challengerssesicrz-sketch/Challengers-Soccer-2026/Fotos/WhatsApp Image 2026-05-27 at 15.08.53.jpeg

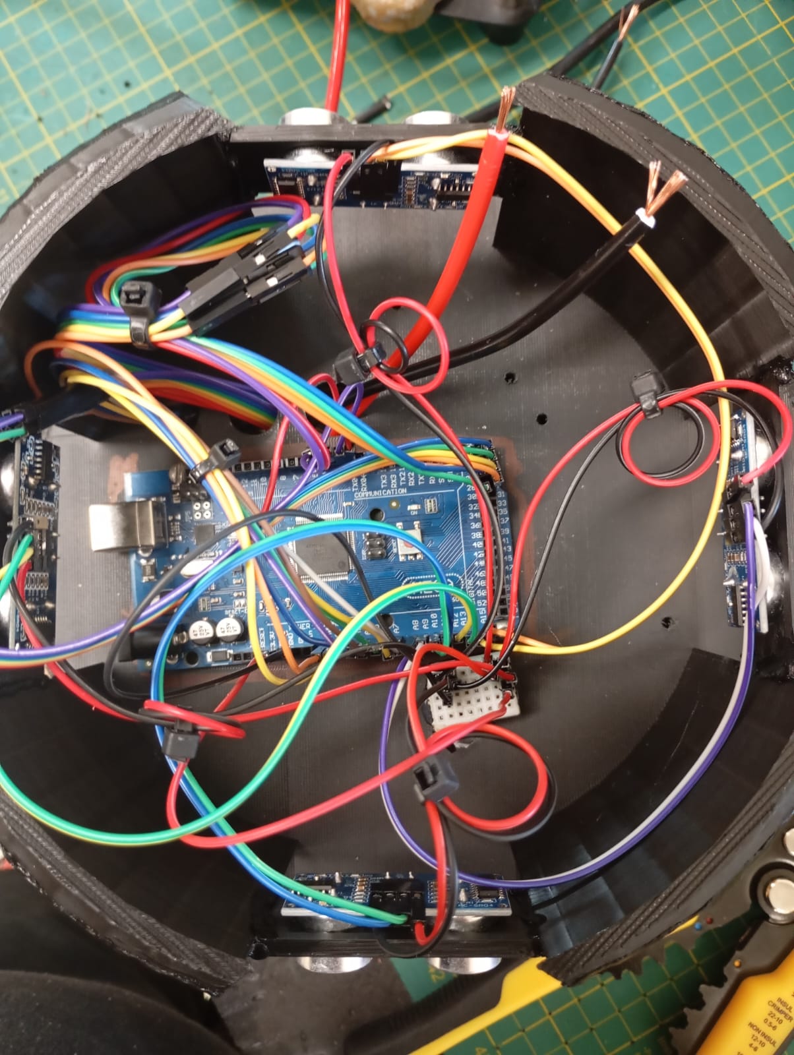
Fotos/WhatsApp Image 2026-05-27 at 15.08.53.jpeg
