challengerssesicrz-sketch/Challengers-Soccer-2026/Fotos/WhatsApp Image 2026-05-18 at 13.47.44 (4).jpeg

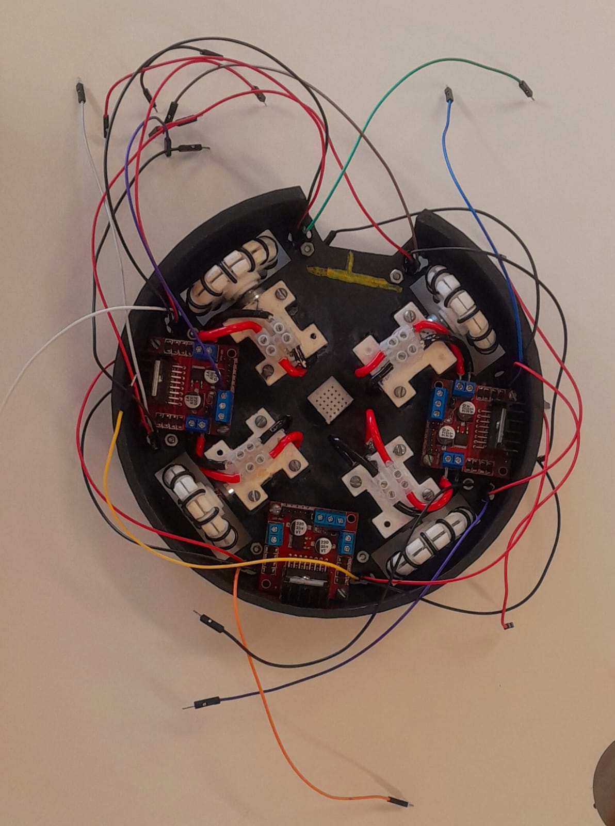
Fotos/WhatsApp Image 2026-05-18 at 13.47.44 (4).jpeg
