challengerssesicrz-sketch/Challengers-Soccer-2026/README.md

# Challengers-Soccer-2026
⚽ Repositório oficial da equipe Challengers (SESI 401 - Cruzeiro/SP). Firmware e documentação dos robôs autônomos de futebol desenvolvidos para a categoria RoboCupJunior Soccer Lightweight 2026. Baseado em Arduino Mega 2560 e design modular de alta performance.
