challengerssesicrz-sketch/Challengers-Soccer-2026/CAD_3D/camada_1_novo-removebg-preview.png

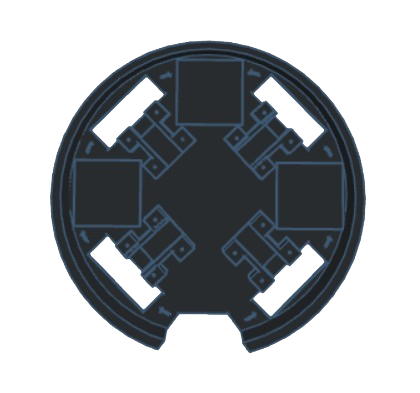
CAD_3D/camada_1_novo-removebg-preview.png
