challengerssesicrz-sketch/Challengers-Soccer-2026/Fotos/WhatsApp Image 2026-05-18 at 16.20.59 (1).jpeg

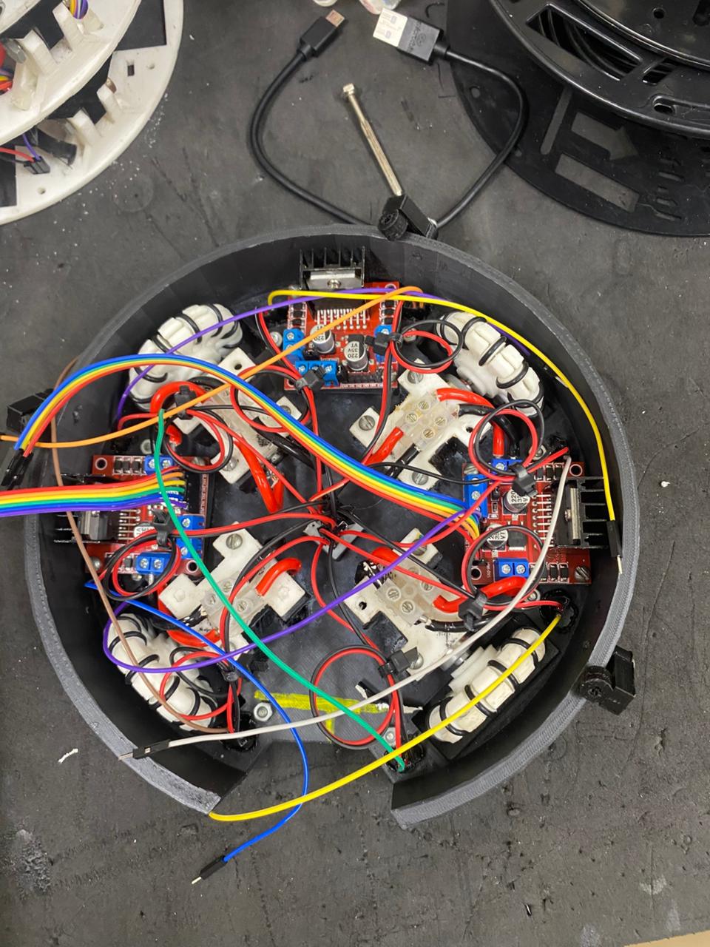
Fotos/WhatsApp Image 2026-05-18 at 16.20.59 (1).jpeg
