challengerssesicrz-sketch/Challengers-Soccer-2026/Fotos/WhatsApp Image 2026-05-27 at 16.37.21 (1).jpeg

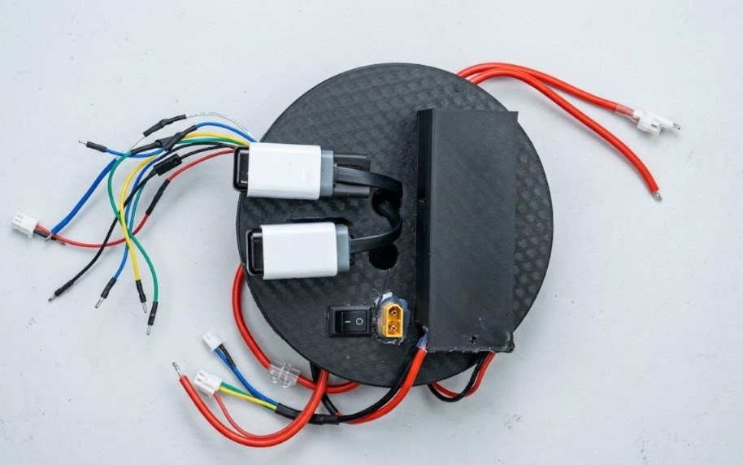
Fotos/WhatsApp Image 2026-05-27 at 16.37.21 (1).jpeg
