challengerssesicrz-sketch/Challengers-Soccer-2026/Fotos/WhatsApp Image 2026-06-11 at 21.22.09 (1).jpeg

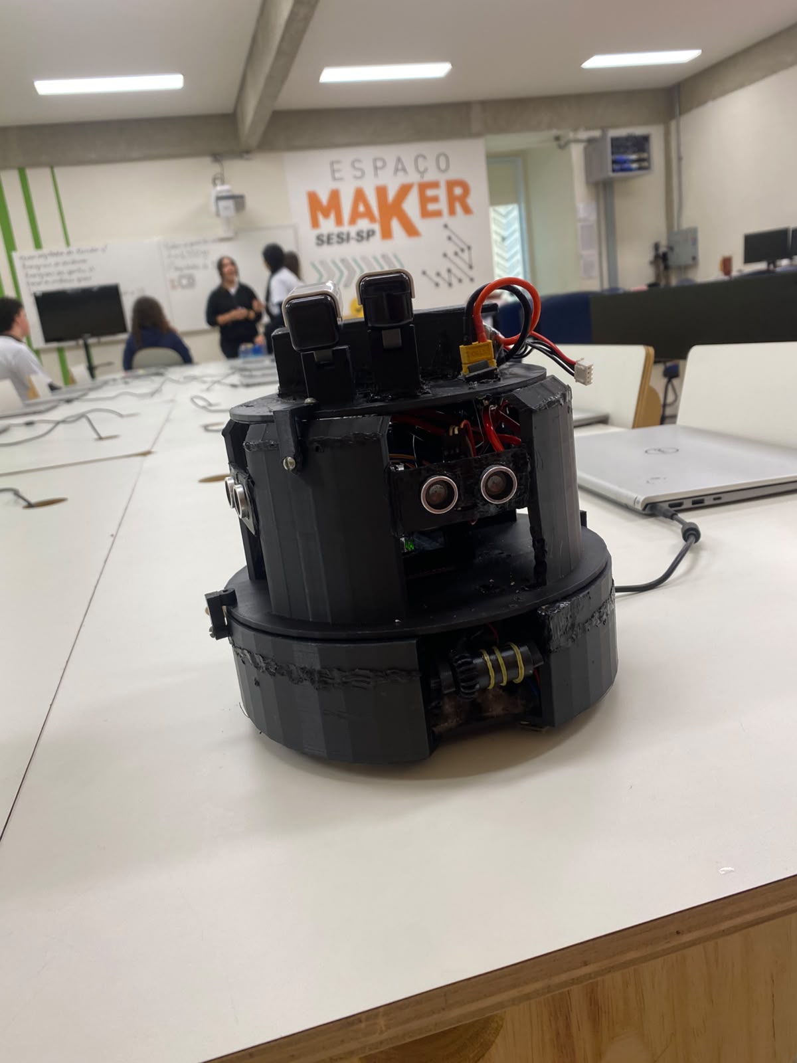
Fotos/WhatsApp Image 2026-06-11 at 21.22.09 (1).jpeg
