challengerssesicrz-sketch/Challengers-Soccer-2026/CAD_3D/Bussola.stl

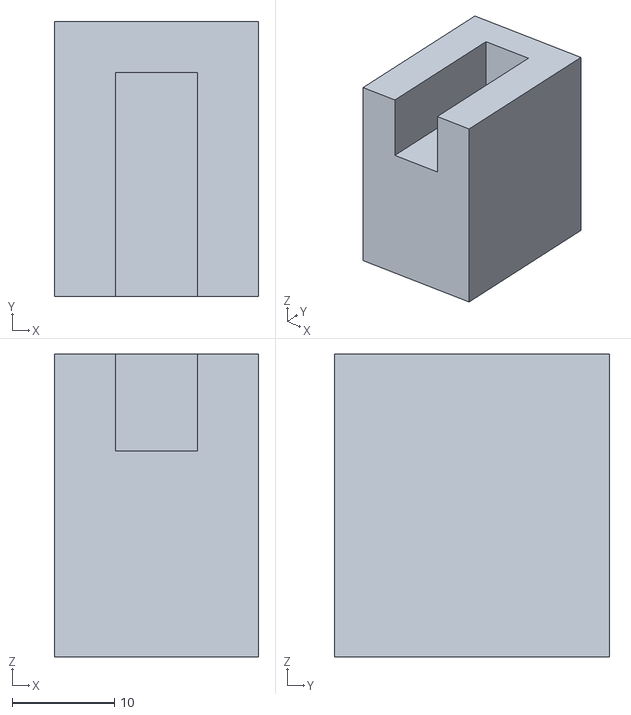
[picture p15: CAD file, 2026-06-13]
CAD_3D/Bussola.stl
20.0 x 27.0 x 29.7
