challengerssesicrz-sketch/Challengers-Soccer-2026/CAD_3D/Driblador (1).stl

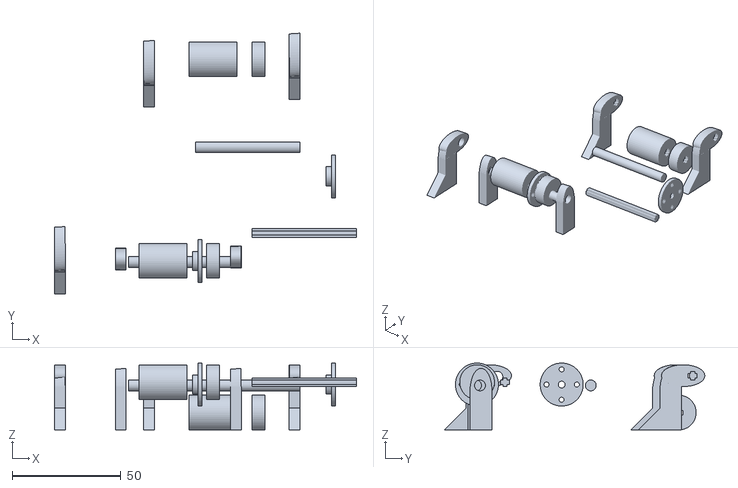
[picture p16: CAD file, 2026-06-13]
CAD_3D/Driblador (1).stl
139.0 x 120.0 x 30.8
