challengerssesicrz-sketch/Challengers-Soccer-2026/CAD_3D/Conector camadas (2).stl

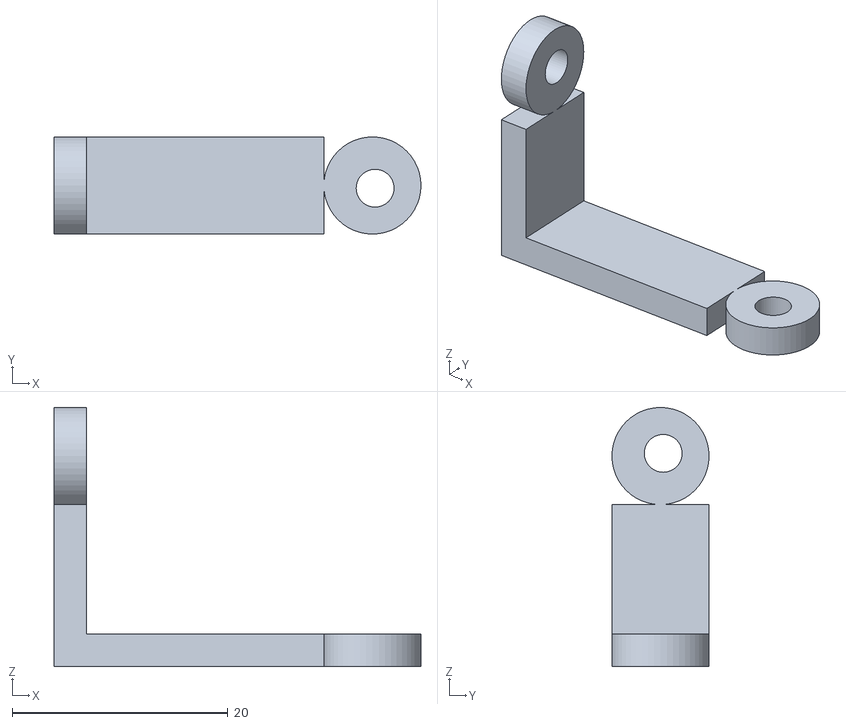
[picture p17: CAD file, 2026-06-13]
CAD_3D/Conector camadas (2).stl
34.0 x 9.00 x 24.0
