challengerssesicrz-sketch/Challengers-Soccer-2026/CAD_3D/4 Camada.stl

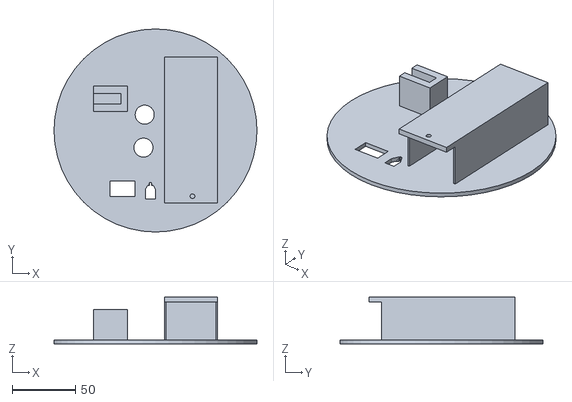
[picture p18: CAD file, 2026-06-13]
CAD_3D/4 Camada.stl
160.0 x 160.0 x 37.0
