challengerssesicrz-sketch/Challengers-Soccer-2026/CAD_3D/Conector camadas (1).stl

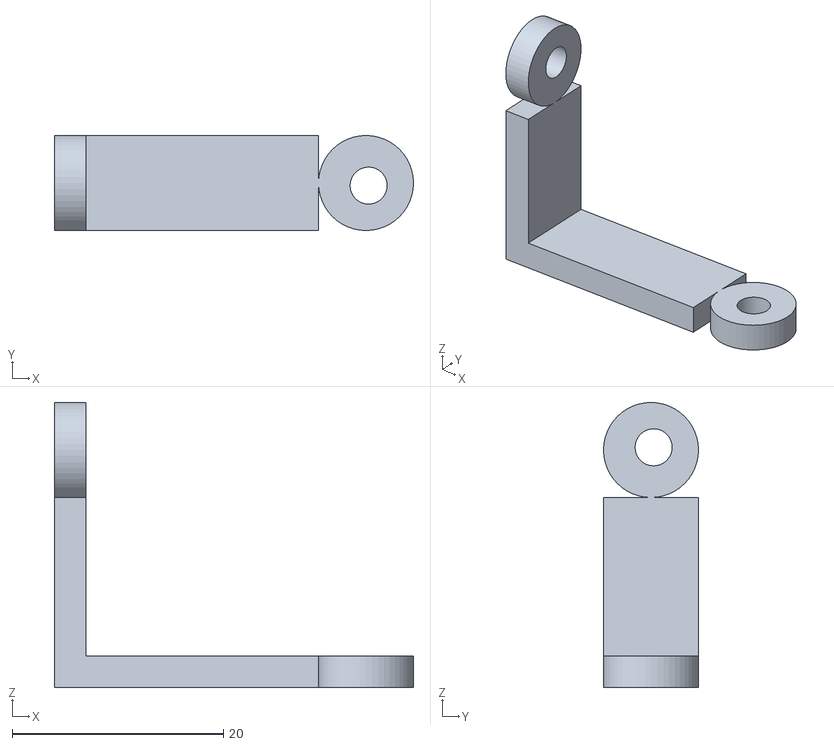
[picture p19: CAD file, 2026-06-13]
CAD_3D/Conector camadas (1).stl
34.0 x 9.00 x 27.0
