challengerssesicrz-sketch/Challengers-Soccer-2026/CAD_3D/Camada 3 (3).stl

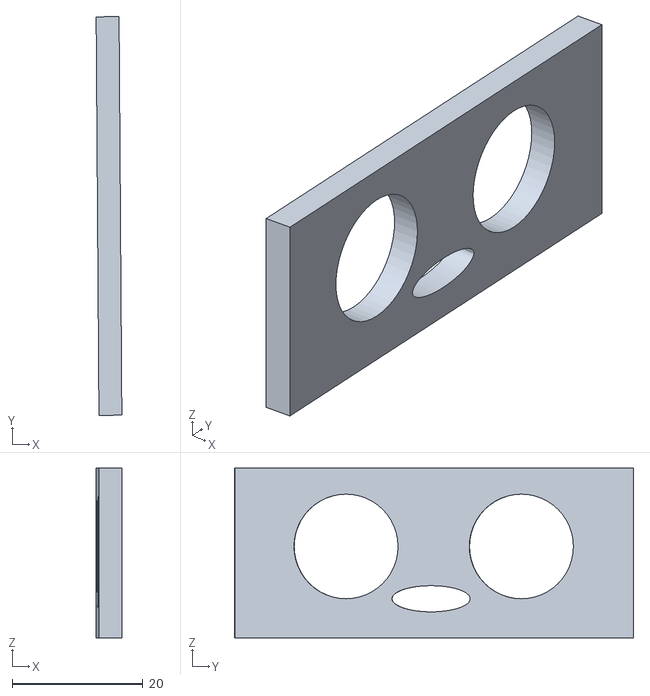
[picture p20: CAD file, 2026-06-13]
CAD_3D/Camada 3 (3).stl
3.94 x 61.1 x 26.0
